Andy4495/TI-30-Keypad-Interface/extras/jpg/Digit segment.jpeg

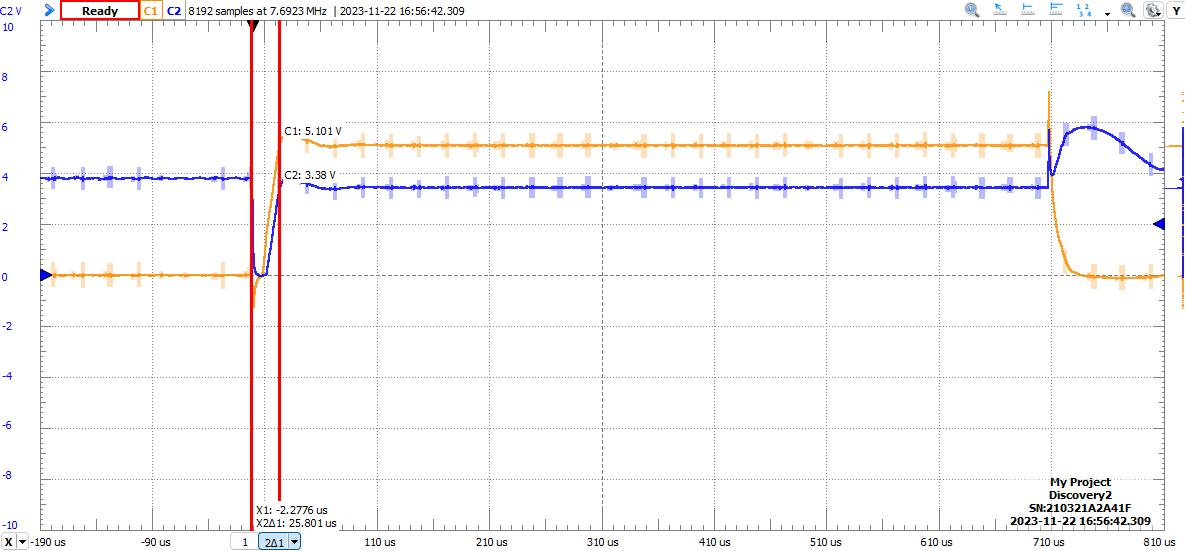
extras/jpg/Digit segment.jpeg
